jfm92/scriptPad/README.md

# scriptPad

The scriptPad project is a macroPad fully customizable with build in USB WebPage allowing to configure every aspect of the device without extra software or web page, everything you need in a single device.

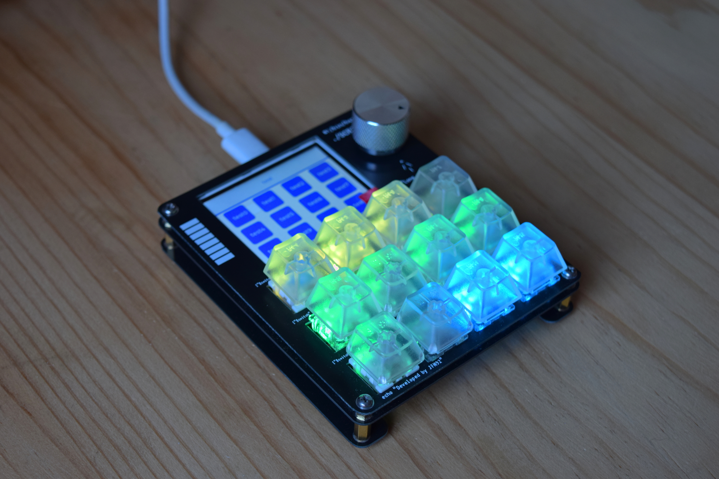
[picture p1: projectPhoto.JPG]


## Work in progess
