jfm92/scriptPad/scriptPad_PCB/graphics/scriptPadBack.png

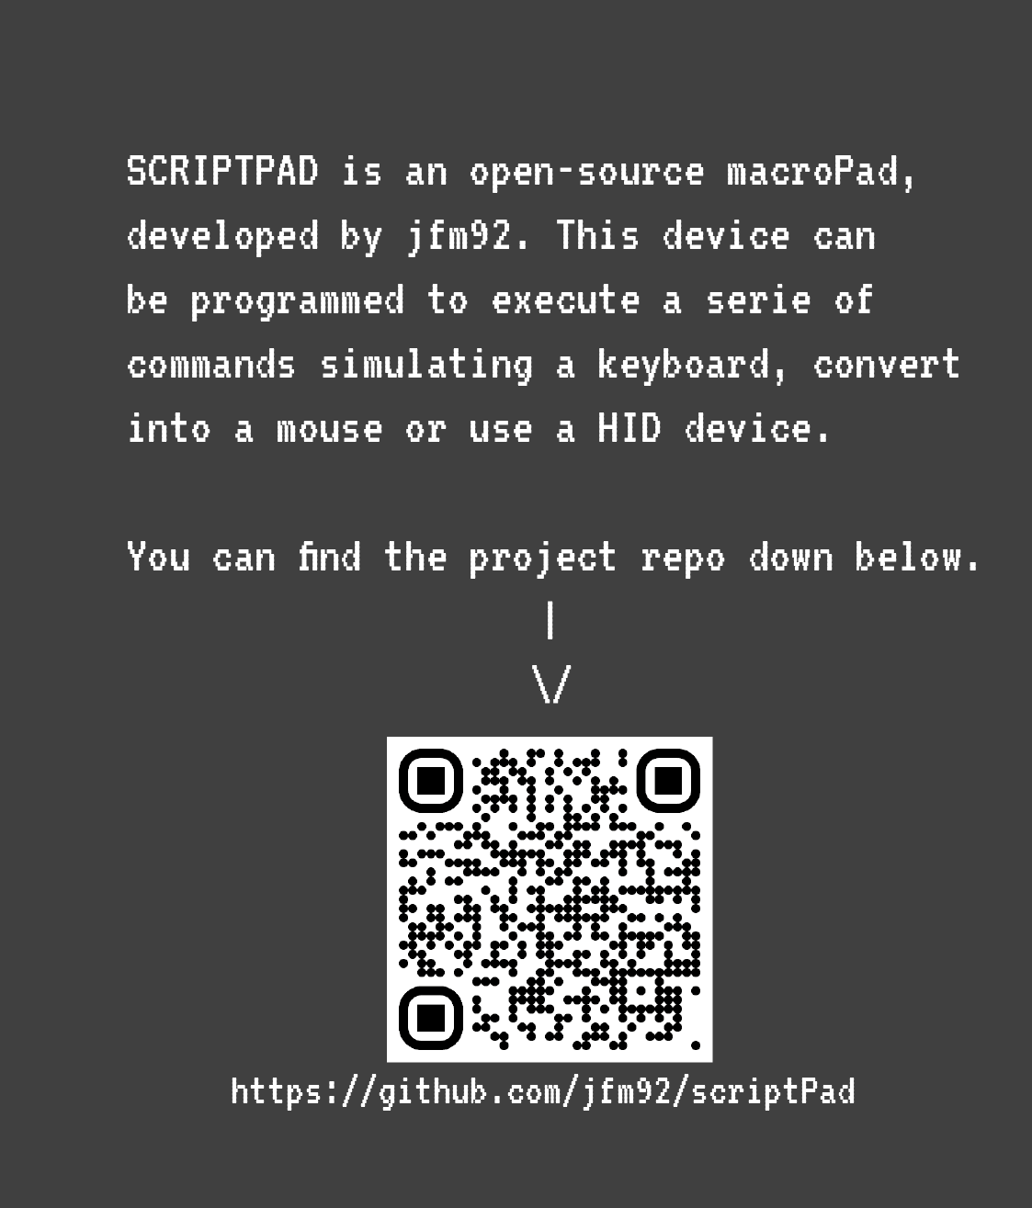
scriptPad_PCB/graphics/scriptPadBack.png
