jfm92/scriptPad/scriptPad_PCB/graphics/scriptPadFront.png

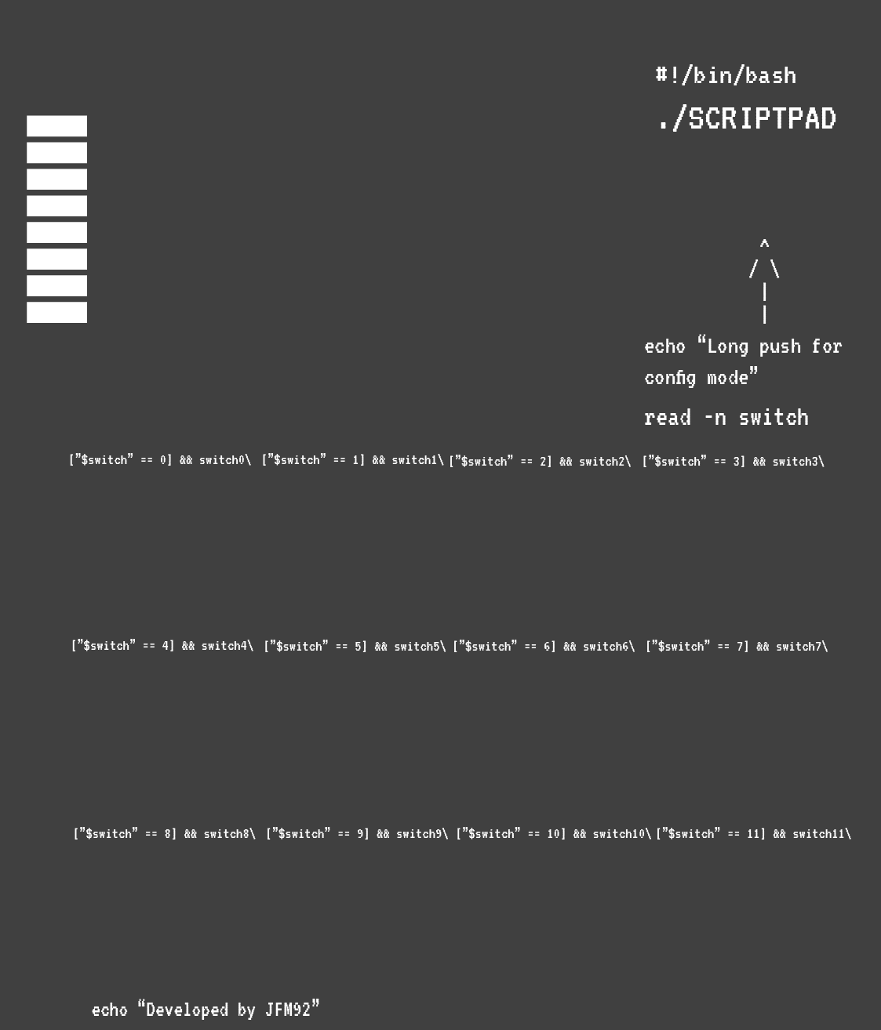
scriptPad_PCB/graphics/scriptPadFront.png
