jfm92/scriptPad/scriptPad_PCB/scriptPad_PCB.kicad_pcb

## KiCad design scriptPad_PCB/scriptPad_PCB.kicad_pcb (2023-12-29)

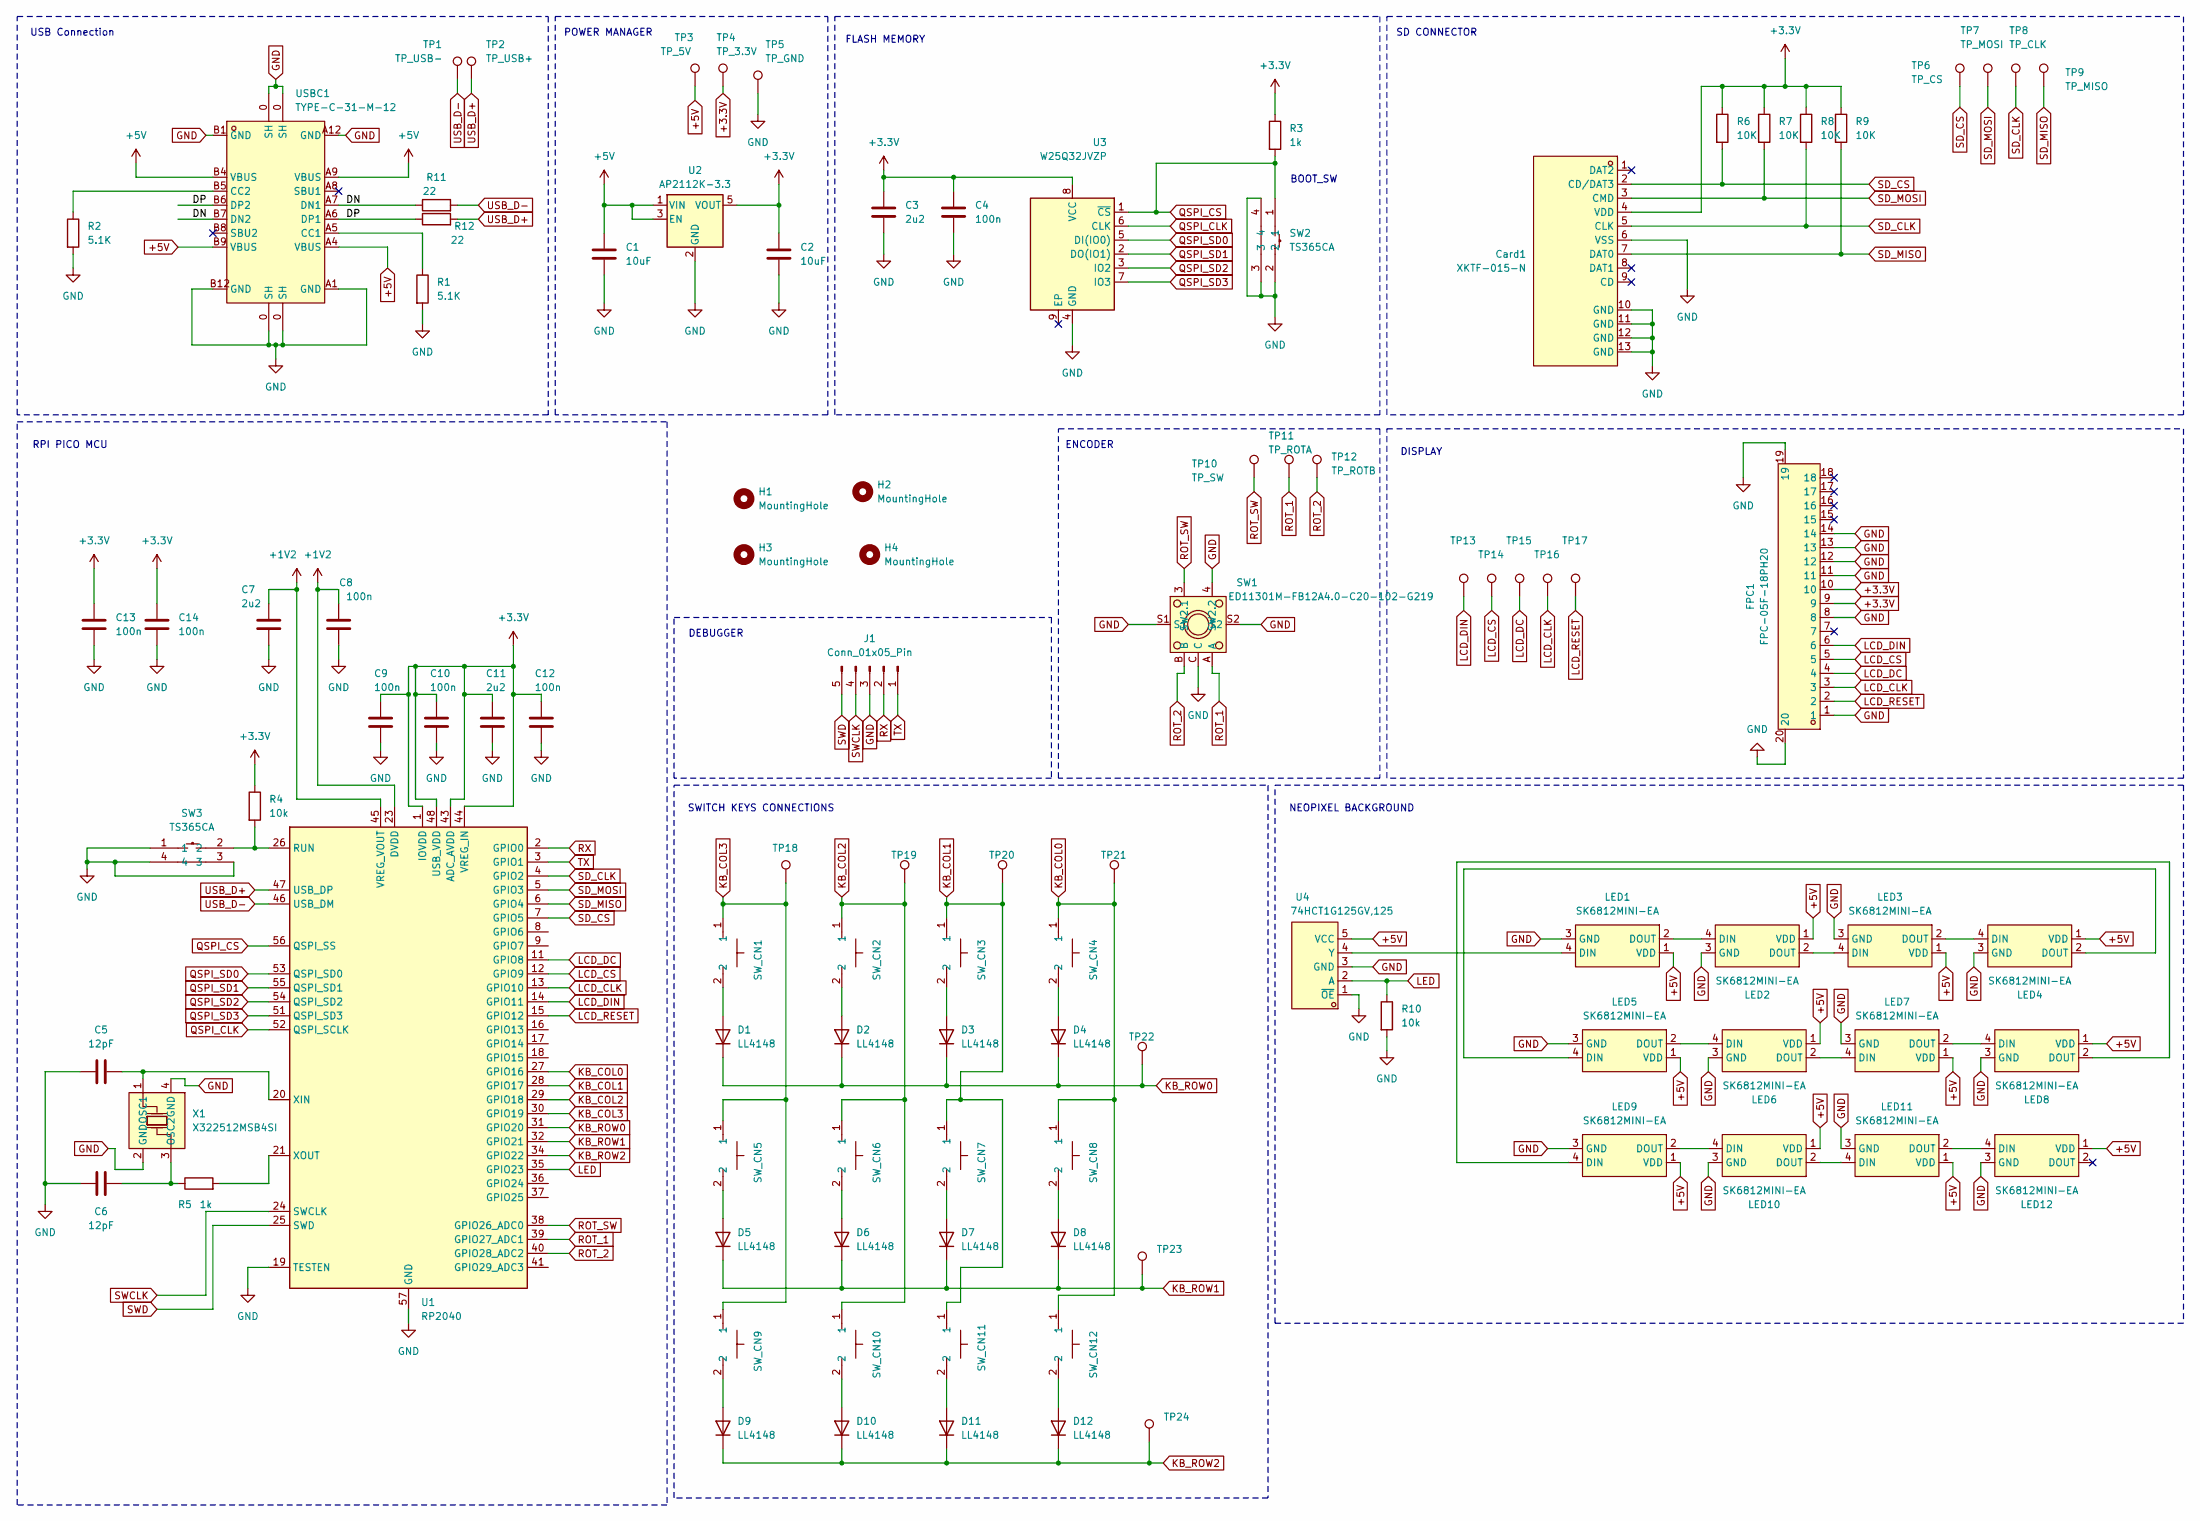
[picture p4: schematic scriptPad_PCB.kicad_sch]

Parts:
C1, C2: 10uF; C_0805_2012Metric; LCSC C17024
C3: 2u2; C_0805_2012Metric; LCSC C19110
C4: 100n; C_0603_1608Metric; LCSC C1591
C5, C6: 12pF; C_0603_1608Metric
C7, C11: 2u2; C_0805_2012Metric
C8, C9, C10, C12, C13, C14: 100n; C_0603_1608Metric
Card1: XKTF-015-N; TF-SMD_XKTF-015-N; LCSC Part C381082
D1: LL4148; D_MiniMELF; LCSC C2891733
D2, D3, D4, D5, D6, D7, D8, D9, D10, D11, D12: LL4148; D_MiniMELF
FPC1: FPC-05F-18PH20; FPC-SMD_18P-P0.50_FPC-05F-18PH20; LCSC Part C2856802
H1, H2, H3, H4: MountingHole; MountingHole_2.7mm_M2.5_Pad
J1: Conn_01x05_Pin; PinHeader_1x05_P1.27mm_Vertical
LED1, LED2, LED3, LED4, LED5, LED6, LED7, LED8, LED9, LED10, LED11, LED12: SK6812MINI-EA; LED-SMD_4P-L3.2-W2.8_SK6812MINI-EA; LCSC Part C5378731
R1, R2: 5.1K; R_0603_1608Metric; LCSC C156350
R3, R5: 1k; R_0805_2012Metric
R4, R10: 10k; R_0805_2012Metric
R6, R7, R8, R9: 10K; R_0805_2012Metric
R11, R12: 22; R_0603_1608Metric; LCSC C25295
SW1: ED11301M-FB12A4.0-C20-102-G219; SW-TH_CTR_ED11301M-FB12A4.0-C20-102-G219; LCSC Part C18213487
SW2, SW3: TS365CA; SW-SMD_TS365CA; LCSC Part C2681480
SW_CN1, SW_CN2, SW_CN3, SW_CN4, SW_CN5, SW_CN6, SW_CN7, SW_CN8, SW_CN9, SW_CN10, SW_CN11, SW_CN12: CPG151101S11-16; SMD_KEYBOARD-SW; LCSC Part C5156480
TP1: TP_USB-; TestPoint_Pad_D2.0mm
TP2: TP_USB+; TestPoint_Pad_D2.0mm
TP3: TP_5V; TestPoint_Pad_D2.0mm
TP4: TP_3.3V; TestPoint_Pad_D2.0mm
TP5: TP_GND; TestPoint_Pad_D2.0mm
TP6: TP_CS; TestPoint_Pad_D2.0mm
TP7: TP_MOSI; TestPoint_Pad_D2.0mm
TP8: TP_CLK; TestPoint_Pad_D2.0mm
TP9: TP_MISO; TestPoint_Pad_D2.0mm
TP10: TP_SW; TestPoint_Pad_D2.0mm
TP11: TP_ROTA; TestPoint_Pad_D2.0mm
TP12: TP_ROTB; TestPoint_Pad_D2.0mm
TP13, TP14, TP15, TP16, TP17, TP18, TP19, TP20, TP21, TP22, TP23, TP24: TestPoint; TestPoint_Pad_D2.0mm
U1: RP2040; QFN-56-1EP_7x7mm_P0.4mm_EP3.2x3.2mm
U2: AP2112K-3.3; SOT-23-5; LCSC C51118
U3: W25Q32JVZP; WSON-8-1EP_6x5mm_P1.27mm_EP3.4x4.3mm
U4: 74HCT1G125GV,125; SOT-753_L3.1-W1.7-P0.95-LS3.0-BL; LCSC Part C12502
USBC1: TYPE-C-31-M-12; USB-C_SMD-TYPE-C-31-M-12; LCSC Part C165948
X1: X322512MSB4SI; OSC-SMD_4P-L3.2-W2.5-BL; LCSC Part C9002

Connections:
+1V2: C7.1, C8.1, U1.23 (DVDD), U1.45 (VREG_VOUT), U1.50 (DVDD)
+3.3V: C2.1, C3.1, C4.1, C9.1, C10.1, C11.1, C12.1, C13.1, C14.1, Card1.4 (VDD), FPC1.9, FPC1.10, R3.1, R4.1, R6.1, R7.1, R8.1, R9.1, TP4.1, U1.1 (IOVDD), U1.10 (IOVDD), U1.22 (IOVDD), U1.33 (IOVDD), U1.42 (IOVDD), U1.43 (ADC_AVDD), U1.44 (VREG_IN), U1.48 (USB_VDD), U1.49 (IOVDD), U2.5 (VOUT), U3.8 (VCC)
+5V: C1.1, LED1.1 (VDD), LED2.1 (VDD), LED3.1 (VDD), LED4.1 (VDD), LED5.1 (VDD), LED6.1 (VDD), LED7.1 (VDD), LED8.1 (VDD), LED9.1 (VDD), LED10.1 (VDD), LED11.1 (VDD), LED12.1 (VDD), TP3.1, U2.1 (VIN), U2.3 (EN), U4.5 (VCC), USBC1.A4 (VBUS), USBC1.A9 (VBUS), USBC1.B4 (VBUS), USBC1.B9 (VBUS)
/DN: R11.1, USBC1.A7 (DN1), USBC1.B7 (DN2)
/DP: R12.1, USBC1.A6 (DP1), USBC1.B6 (DP2)
GND: C1.2, C2.2, C3.2, C4.2, C5.2, C6.2, C7.2, C8.2, C9.2, C10.2, C11.2, C12.2, C13.2, C14.2, Card1.6 (VSS), Card1.10 (GND), Card1.11 (GND), Card1.12 (GND), Card1.13 (GND), FPC1.1, FPC1.8, FPC1.11, FPC1.12, FPC1.13, FPC1.14, FPC1.19, FPC1.20, J1.3, LED1.3 (GND), LED2.3 (GND), LED3.3 (GND), LED4.3 (GND), LED5.3 (GND), LED6.3 (GND), LED7.3 (GND), LED8.3 (GND), LED9.3 (GND), LED10.3 (GND), LED11.3 (GND), LED12.3 (GND), R1.2, R2.2, R10.2, SW1.4 (SW2.2), SW1.C, SW1.S1, SW1.S2, SW2.2, SW2.3, SW2.4, SW3.1, SW3.3, SW3.4, TP5.1, U1.19 (TESTEN), U1.57 (GND), U2.2 (GND), U3.4 (GND), U4.1 (~OE), U4.3 (GND), USBC1.0 (SH), USBC1.A1 (GND), USBC1.A12 (GND), USBC1.B1 (GND), USBC1.B12 (GND), X1.2 (GND), X1.4 (GND)
KB_COL0: SW_CN4.1, SW_CN8.1, SW_CN12.1, TP21.1, U1.27 (GPIO16)
KB_COL1: SW_CN3.1, SW_CN7.1, SW_CN11.1, TP20.1, U1.28 (GPIO17)
KB_COL2: SW_CN2.1, SW_CN6.1, SW_CN10.1, TP19.1, U1.29 (GPIO18)
KB_COL3: SW_CN1.1, SW_CN5.1, SW_CN9.1, TP18.1, U1.30 (GPIO19)
KB_ROW0: D1.1 (K), D2.1 (K), D3.1 (K), D4.1 (K), TP22.1, U1.31 (GPIO20)
KB_ROW1: D5.1 (K), D6.1 (K), D7.1 (K), D8.1 (K), TP23.1, U1.32 (GPIO21)
KB_ROW2: D9.1 (K), D10.1 (K), D11.1 (K), D12.1 (K), TP24.1, U1.34 (GPIO22)
LCD_CLK: FPC1.3, TP16.1, U1.13 (GPIO10)
LCD_CS: FPC1.5, TP14.1, U1.12 (GPIO9)
LCD_DC: FPC1.4, TP15.1, U1.11 (GPIO8)
LCD_DIN: FPC1.6, TP13.1, U1.14 (GPIO11)
LCD_RESET: FPC1.2, TP17.1, U1.15 (GPIO12)
LED: R10.1, U1.35 (GPIO23), U4.2 (A)
unnamed: D1.2 (A), SW_CN1.2
unnamed: D2.2 (A), SW_CN2.2
unnamed: D3.2 (A), SW_CN3.2
unnamed: D4.2 (A), SW_CN4.2
unnamed: D5.2 (A), SW_CN5.2
unnamed: D6.2 (A), SW_CN6.2
unnamed: D7.2 (A), SW_CN7.2
unnamed: D8.2 (A), SW_CN8.2
unnamed: D9.2 (A), SW_CN9.2
unnamed: D10.2 (A), SW_CN10.2
unnamed: D11.2 (A), SW_CN11.2
unnamed: D12.2 (A), SW_CN12.2
unnamed: LED1.4 (DIN), U4.4 (Y)
unnamed: LED1.2 (DOUT), LED2.4 (DIN)
unnamed: LED2.2 (DOUT), LED3.4 (DIN)
unnamed: LED3.2 (DOUT), LED4.4 (DIN)
unnamed: LED4.2 (DOUT), LED5.4 (DIN)
unnamed: LED5.2 (DOUT), LED6.4 (DIN)
unnamed: LED6.2 (DOUT), LED7.4 (DIN)
unnamed: LED7.2 (DOUT), LED8.4 (DIN)
unnamed: LED8.2 (DOUT), LED9.4 (DIN)
unnamed: LED9.2 (DOUT), LED10.4 (DIN)
unnamed: LED10.2 (DOUT), LED11.4 (DIN)
unnamed: LED11.2 (DOUT), LED12.4 (DIN)
unnamed: R4.2, SW3.2, U1.26 (RUN)
unnamed: C5.1, U1.20 (XIN), X1.1 (OSC1)
unnamed: R5.2, U1.21 (XOUT)
unnamed: R1.1, USBC1.A5 (CC1)
unnamed: R2.1, USBC1.B5 (CC2)
unnamed: C6.1, R5.1, X1.3 (OSC2)
QSPI_CLK: U1.52 (QSPI_SCLK), U3.6 (CLK)
QSPI_CS: R3.2, SW2.1, U1.56 (QSPI_SS), U3.1 (~CS)
QSPI_SD0: U1.53 (QSPI_SD0), U3.5 (DI(IO0))
QSPI_SD1: U1.55 (QSPI_SD1), U3.2 (DO(IO1))
QSPI_SD2: U1.54 (QSPI_SD2), U3.3 (IO2)
QSPI_SD3: U1.51 (QSPI_SD3), U3.7 (IO3)
ROT_1: SW1.A, TP11.1, U1.39 (GPIO27_ADC1)
ROT_2: SW1.B, TP12.1, U1.40 (GPIO28_ADC2)
ROT_SW: SW1.3 (SW2.1), TP10.1, U1.38 (GPIO26_ADC0)
RX: J1.2, U1.2 (GPIO0)
SD_CLK: Card1.5 (CLK), R8.2, TP8.1, U1.4 (GPIO2)
SD_CS: Card1.2 (CD/DAT3), R6.2, TP6.1, U1.7 (GPIO5)
SD_MISO: Card1.7 (DAT0), R9.2, TP9.1, U1.6 (GPIO4)
SD_MOSI: Card1.3 (CMD), R7.2, TP7.1, U1.5 (GPIO3)
SWCLK: J1.4, U1.24 (SWCLK)
SWD: J1.5, U1.25 (SWD)
TX: J1.1, U1.3 (GPIO1)
USB_D+: R12.2, TP2.1, U1.47 (USB_DP)
USB_D-: R11.2, TP1.1, U1.46 (USB_DM)

Notes on the sheet:
DEBUGGER
NEOPIXEL BACKGROUND
DISPLAY
POWER MANAGER
SD CONNECTOR
SWITCH KEYS CONNECTIONS
BOOT_SW
ENCODER
RPI PICO MCU
USB Connection
FLASH MEMORY

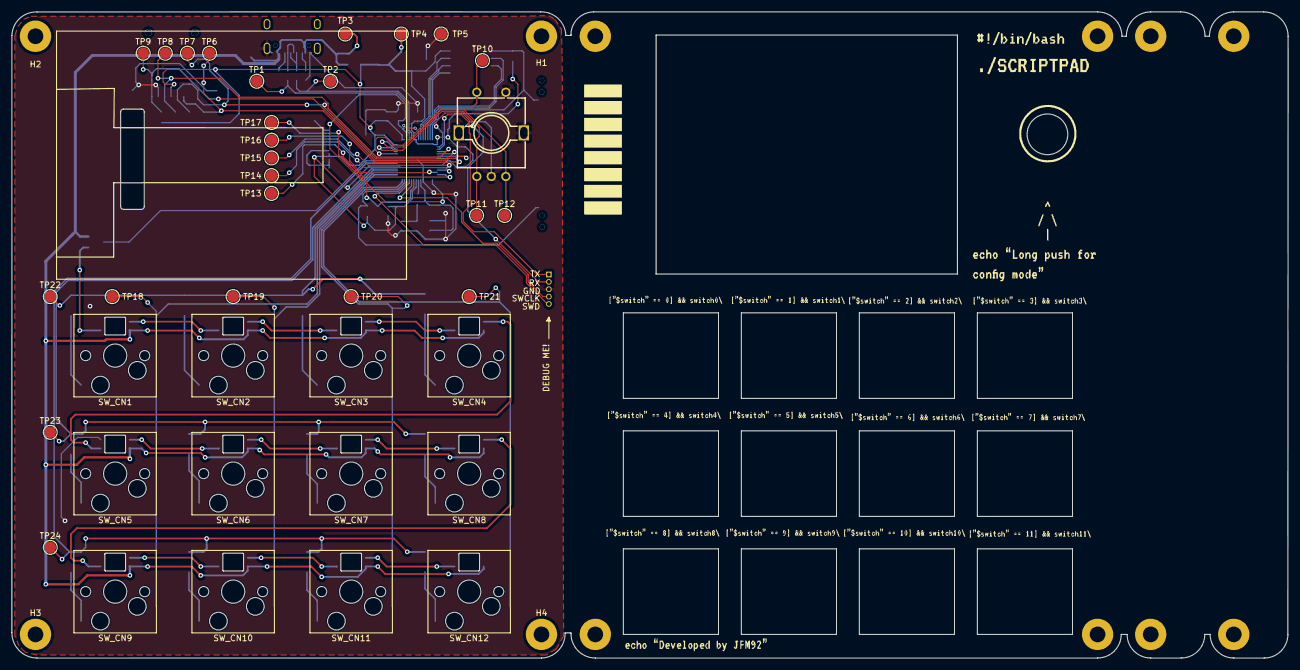
[picture p5: board scriptPad_PCB.kicad_pcb from above]

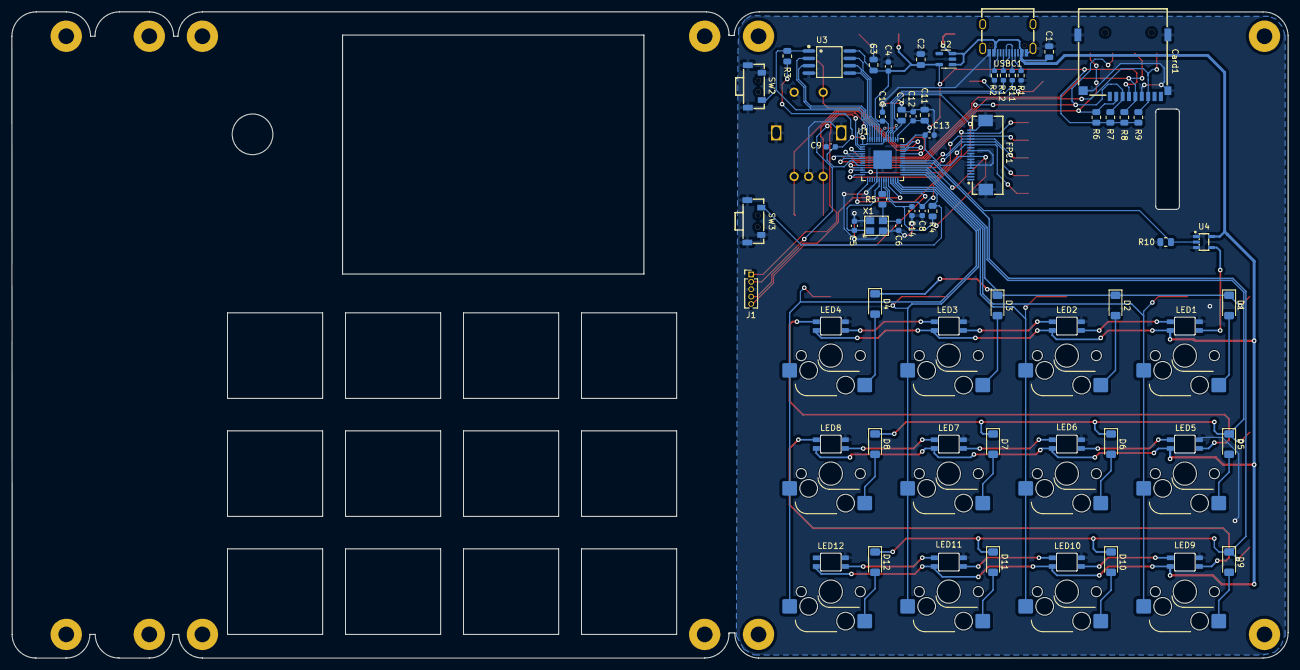
[picture p6: board scriptPad_PCB.kicad_pcb from below]

Board: 2 copper layers, 219.7 x 111.3 mm, 103 parts (61 on the bottom side), 68 nets.

Other parts of the board:
H4#2: MountingHole; MountingHole_2.7mm_M2.5_Pad
