jfm92/scriptPad/scriptPad_firmware/filesManagement/hw_config.c

#include "hw_config.h"

/* Configuration of RP2040 hardware SPI object */
static spi_t spi = {  
    .hw_inst = spi0,  // RP2040 SPI component
    .sck_gpio = 2,    // GPIO number (not Pico pin number)
    .mosi_gpio = 3,
    .miso_gpio = 4,
    .baud_rate = 12 * 1000 * 1000   // Actual frequency: 10416666.
};

/* SPI Interface */
static sd_spi_if_t spi_if = {
    .spi = &spi,  // Pointer to the SPI driving this card
    .ss_gpio = 5     // The SPI slave select GPIO for this SD card
};

/* Configuration of the SD Card socket object */
static sd_card_t sd_card = {   
    /* "pcName" is the FatFs "logical drive" identifier.
    (See http://elm-chan.org/fsw/ff/doc/filename.html#vol) */
    .pcName = "0:",
    .type = SD_IF_SPI,
    .spi_if_p = &spi_if  // Pointer to the SPI interface driving this card
};

/* ********************************************************************** */

size_t sd_get_num() { return 1; }

sd_card_t *sd_get_by_num(size_t num) {
    if (0 == num) {
        return &sd_card;
    } else {
        return NULL;
    }
}
