jfm92/scriptPad/(commit log)

2023-10-12 Adding class to handle switch control/init
2023-10-16 Improving class encapsulation to avoid global variables ussage to interact between class and callbacks
    [switchManagement.cpp, switchManagement.h]
2023-10-17 Adding pico-filesystem library
2023-10-17 Updating pico-sdk route
2023-10-18 Rework to use cJSON library to get switch configuration
2023-10-18 Comming back to previous pico-filesystem repo
2023-10-18 Deleting not necessary library and adding for have trace
2023-10-19 Basic implementation to transform the device into an USB Modem
2023-10-21 Basic implementation of ST7789V driver
2023-10-23 Moving display driver to GUI folder and adding function to draw incoming image matrix
2023-10-25 Rework to use a real switch matrix
    [hwConfig.h, switchManagement.cpp, switchManagement.h]
2023-10-27 Adding a singletone to driver, to allow control from single instance
2023-11-02 Adding no-OS-FatFS-SD-SDIO-SPI-RPi-Pico library to manage SD card to save configs
2023-11-02 Removed pico-filesystem submodule
2023-11-02 General fixes due to it didn't like direct pointer
    [filesManagement.cpp, filesManagement.h]
2023-11-10 Adding initial version of the PCB
    [scriptPad_PCB.kicad_pcb, scriptPad_PCB.kicad_sch]
2023-11-17 Adding dynamic profile and button matrix creation2
2023-11-25 Fixing partial screen update
    [ST7789V.cpp]
2023-11-28 Implementing initial encoder management
2023-12-01 Fixing corrupted character when writes to SD
    [filesManagement.cpp]
2023-12-29 Setting GPIO config for the matrix on latest PCB model
2023-12-29 Updating PCB to new version
    [scriptPad_PCB-B_Cu.gbr, scriptPad_PCB-B_Mask.gbr, scriptPad_PCB-B_Paste.gbr, scriptPad_PCB-B_Silkscreen.gbr, scriptPad_PCB-Edge_Cuts.gbr, scriptPad_PCB-F_Cu.gbr, scriptPad_PCB-F_Fab.gbr, scriptPad_PCB-F_Mask.gbr]
2024-01-08 Small update to show device
2024-01-16 Changing encoder pins from a generic list to ID - GPIO
2024-01-16 Fnctional implementation of rotatory encoder to set ID on each rotation and simple/long pulse implementation
2024-01-16 Making available the encoder on system initialization
